zj308/xiaoyunbao/03_摄像头/摄像头接线与判定.md

# OV2640 接线与判定

GND->GND，3V3->3.3V，SCL->GPIO2，SDA->GPIO1，D0..D7->GPIO16/17/38/39/40/41/42/43，PCLK->GPIO44，VS->GPIO47，HREF->GPIO46，RST->3.3V，PWDN->GND，FLASH 不接，XCLK 不接（模组有 Y1 晶振）。SDA/SCL 若空闲不是 1/1，各加约 4.7K 上拉到 3.3V。

测试串口 115200，输入 `c` 抓帧、`p` 切换 RGB565、`t` 采样、`r` 重试。成功日志应有 PID=0x26、VER=0x42 和 320x240 抓帧成功。0x106/ACK 否时检查供电、PWDN、RST、SCCB、晶振和线序；GPIO48 是板载 RGB 灯脚，不能接 HREF。
