zj308/xiaoyunbao/02_主程序/SmartCompanionS3/摄像头情绪识别-v109说明.md

# 主程序中转情绪识别 v110

烧录入口：

`C:\Users\xijie\Documents\Codex\2026-09-05\longlinshuoxi-wav\小云宝项目-完整交接包-2026-09-12\02_主程序\SmartCompanionS3\SmartCompanionS3.ino`

固件版本：

`2026-09-18-relay-cam-emotion-v110`

Arduino IDE 选项见同目录 `烧录选项.txt`。摄像头挡住 Type-C 时，先拔摄像头烧录，再插回模块并用电池上电。

## 分工

ESP32-S3 不在本地运行 ONNX/MediaPipe。设备在空闲状态下每 3 秒抓一张 JPEG QVGA，经 WebSocket 发给中转服务器。服务器跑情绪模型，再回 `vision.emotion`。下一轮对话会带上最近 20 秒内的视觉线索；生气/害怕/惊讶且置信度足够时，空闲状态可主动关怀。

## 设备侧稳定策略

- 摄像头初始化和抓帧都在独立 FreeRTOS 任务中运行；
- ASR 录音、TTS 播放、动画、配网期间暂停抓帧和上传；
- 优先使用已验证的 JPEG QVGA + PSRAM；
- PLL 依次尝试 12、24、20 MHz；
- JPEG 均失败才回退 RGB565 QQVGA + DRAM + 12 MHz；
- 初始化后不再对 PCLK、VSYNC、HREF 调用 `pinMode()`；
- 连续 3 次抓帧失败后停止采集，5 秒后有限重试；
- 初始化失败按 5、10、20、30 秒上限退避。

## 正常串口日志

```text
2026-09-18-relay-cam-emotion-v110
摄像头：冷启动后台初始化；空闲时每3秒上传JPEG识别情绪
摄像头后台任务已启动
摄像头已检测到，等待供电稳定后初始化
主程序摄像头尝试 format=4 size=5 pll=12MHz
主程序摄像头初始化 ESP_OK
摄像头 DVP: P=... V=... H=...
摄像头预热帧成功 320x240 ...B format=4
摄像头就绪，开始情绪识别
已上传情绪帧 ...B
视觉情绪: happy ok=yes face=yes
```

每 30 秒输出统计：

```text
摄像头统计 ready=1 fmt=4 capture=成功数/尝试数 upload=上传数
```

## 情绪触发

- `happy / neutral`：只作为下一轮对话的视觉线索，不主动播报；
- `angry / fear / surprise`：服务器达到置信度和类别间隔阈值后，可在设备空闲时主动关怀；
- 主动关怀冷却 90 秒；
- 英语模式不触发视觉主动播报；
- 没有人脸、推理失败或置信度不足时不主动说话。

## 中转服务器

把下面两个 ONNX 放到 `04_服务器/relay-server/models/emotion/` 后重启服务：

- `fusion_v1_int8_realdata_qdq.onnx`
- `local_visual_v1_fp32_realdata.onnx`

可选：安装 MediaPipe 后真人脸检测更准。启动日志出现 `视觉情绪: ready` 才表示模型已加载。

云端服务更新并重启后，设备才会收到 `vision.emotion`。本机交接包有代码不等于云服务器已经更新。
