zj308/xiaoyunbao/02_主程序/UI资源参考/base_char.jpg

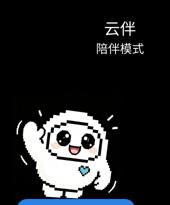
02_主程序/UI资源参考/base_char.jpg
