zj308/xiaoyunbao/02_主程序/UI资源参考/enlish-240.png

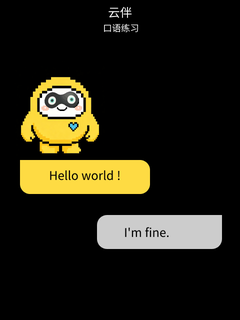
02_主程序/UI资源参考/enlish-240.png
