zj308/xiaoyunbao/02_主程序/UI资源参考/ui1.1.bmp

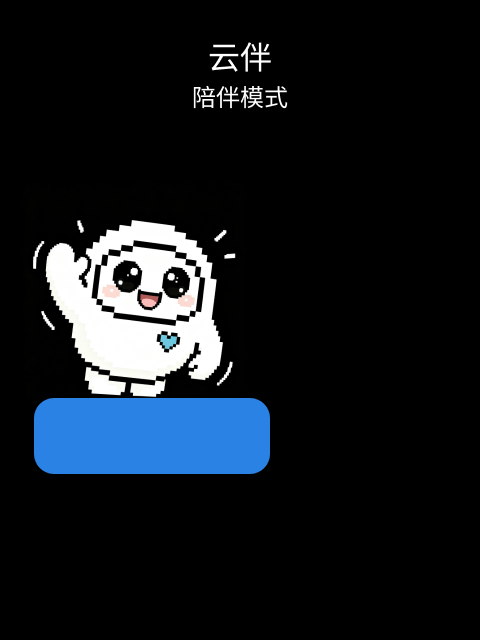
02_主程序/UI资源参考/ui1.1.bmp
