zj308/xiaoyunbao/(list of files, drawings)

Other design files:
05_硬件与EDA/嘉立创板子/work-v103-drc/analysis/pcb_slim.json
