zj308/xiaoyunbao/(commit log)

2026-10-02 Publish XiaoYunBao without cloud credentials.
    [partitions.csv, pcb_slim.json]
2026-10-02 Publish only device firmware and relay code.
    [pcb_slim.json]
